Ladvien/cycloidal_drive/README.md

# cycloidal_drive
NEMA17 based cycloidal 3D printed drive
