Ladvien/cycloidal_drive/docs/design/img/exploded.png

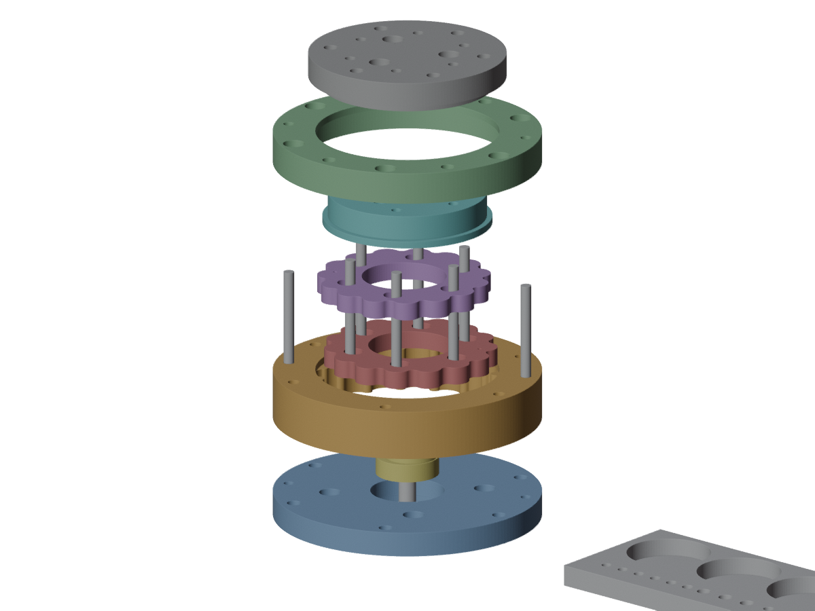
docs/design/img/exploded.png
