Ladvien/cycloidal_drive/docs/design/img/half_section.png

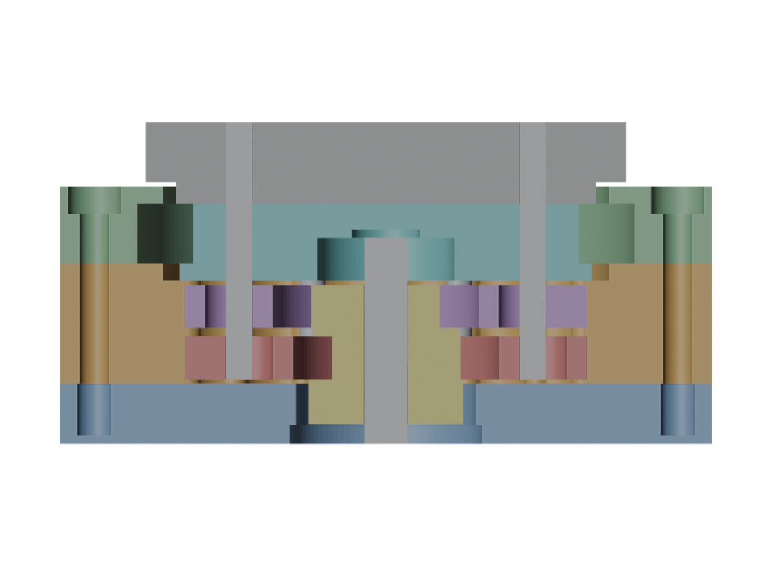
docs/design/img/half_section.png
