Ladvien/cycloidal_drive/docs/design/img/live/exploded.png

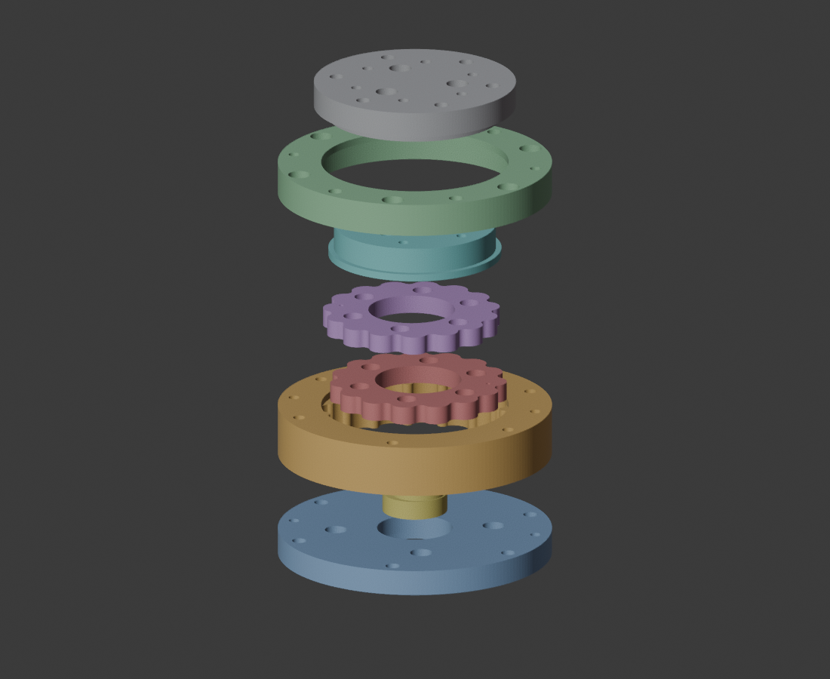
docs/design/img/live/exploded.png
