Ladvien/cycloidal_drive/docs/design/img/live/half_section.png

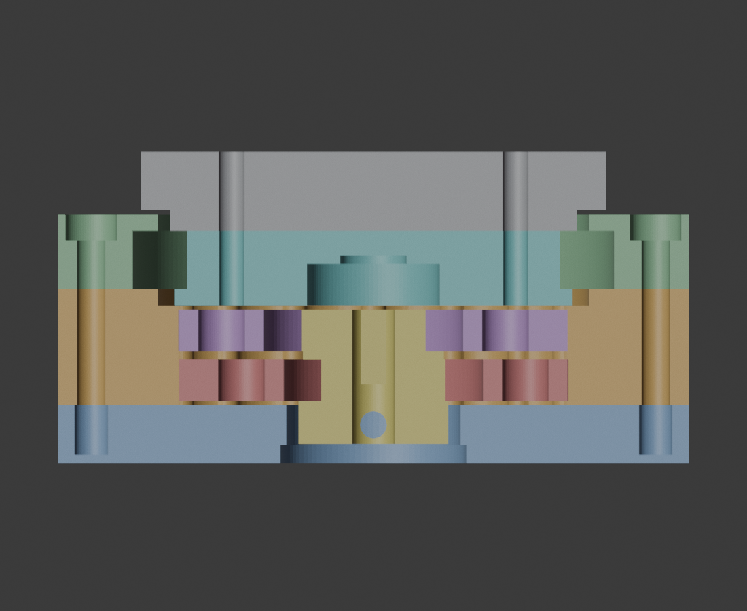
docs/design/img/live/half_section.png
