Ladvien/cycloidal_drive/docs/design/img/live/part_P0_coupon.png

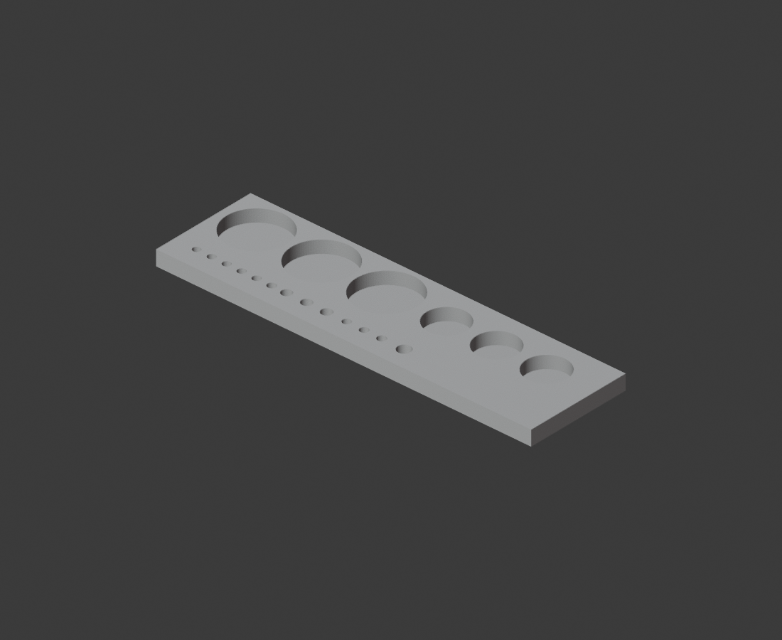
docs/design/img/live/part_P0_coupon.png
