Ladvien/cycloidal_drive/docs/design/img/live/part_P1_base.png

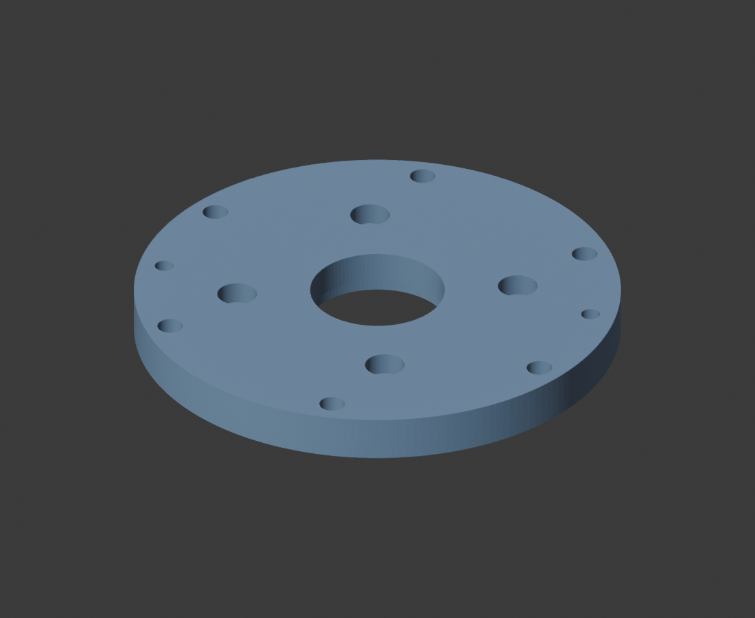
docs/design/img/live/part_P1_base.png
