Ladvien/cycloidal_drive/docs/design/img/live/part_P2_ring.png

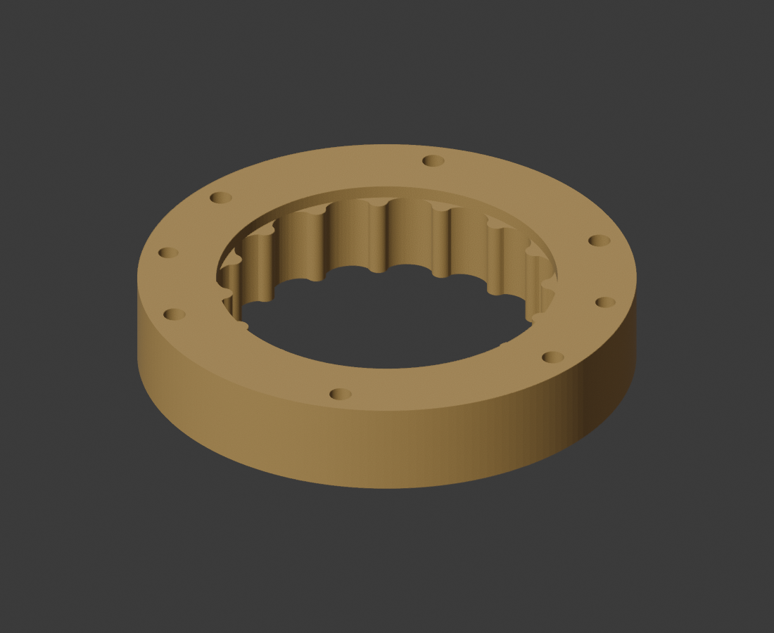
docs/design/img/live/part_P2_ring.png
