Ladvien/cycloidal_drive/docs/design/img/live/part_P3_cap.png

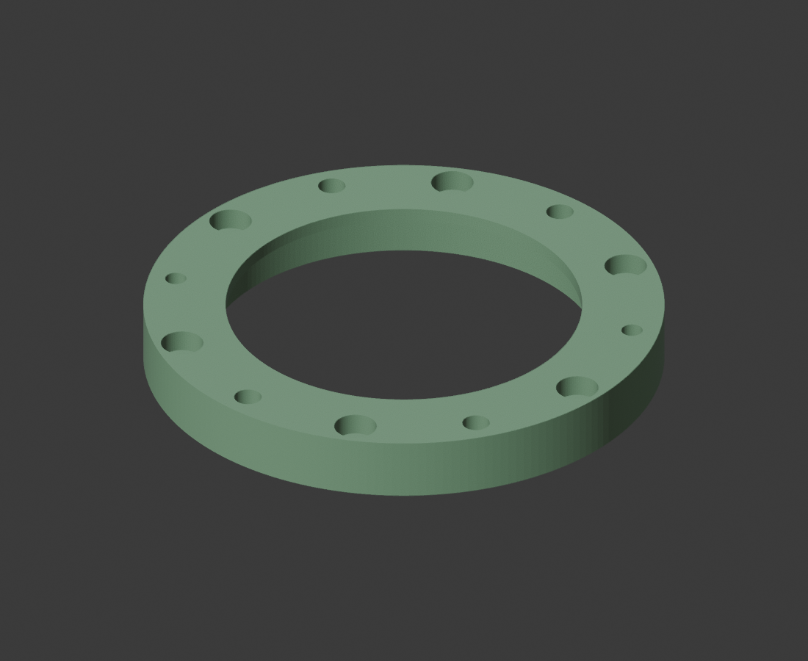
docs/design/img/live/part_P3_cap.png
