Ladvien/cycloidal_drive/docs/design/img/live/part_P5_cam.png

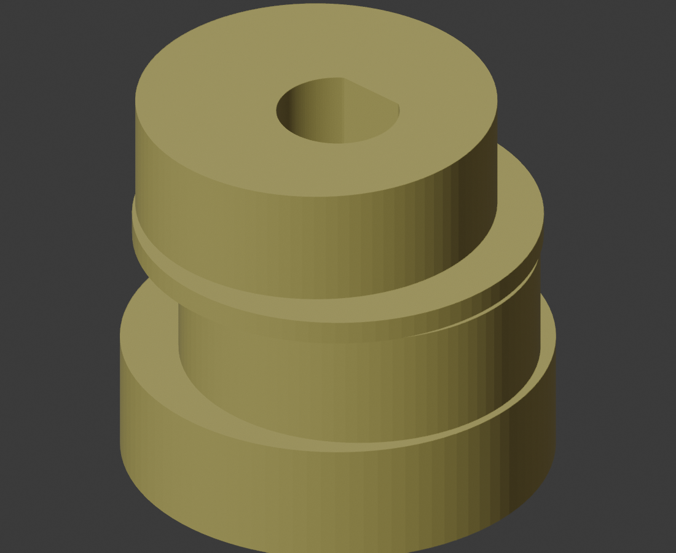
docs/design/img/live/part_P5_cam.png
