Ladvien/cycloidal_drive/docs/design/img/live/part_P6_carrier_lower.png

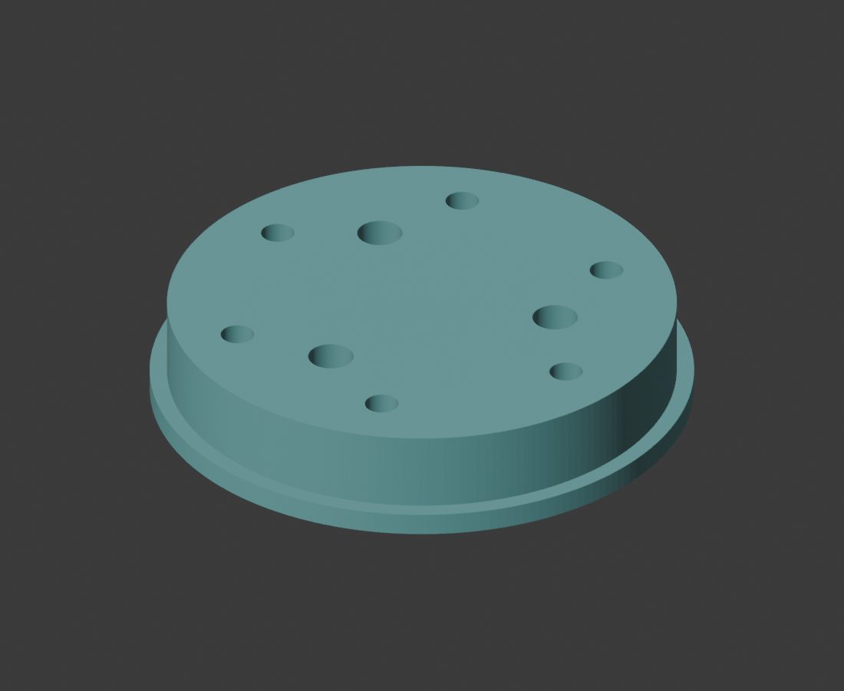
docs/design/img/live/part_P6_carrier_lower.png
