Ladvien/cycloidal_drive/docs/design/img/live/part_P7_carrier_upper.png

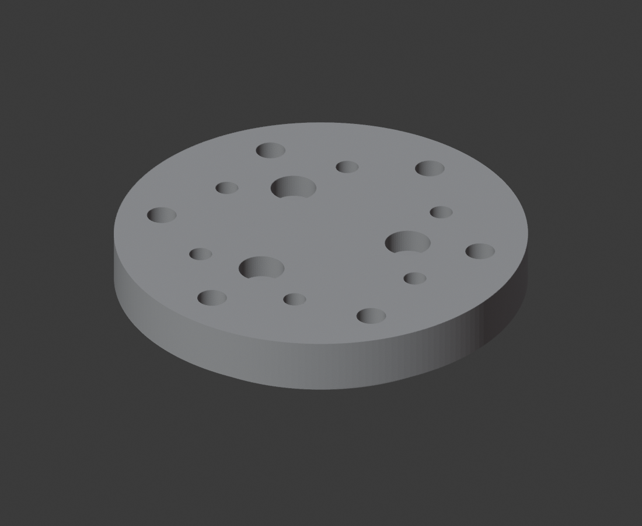
docs/design/img/live/part_P7_carrier_upper.png
