Ladvien/cycloidal_drive/docs/design/img/top_pinzone.png

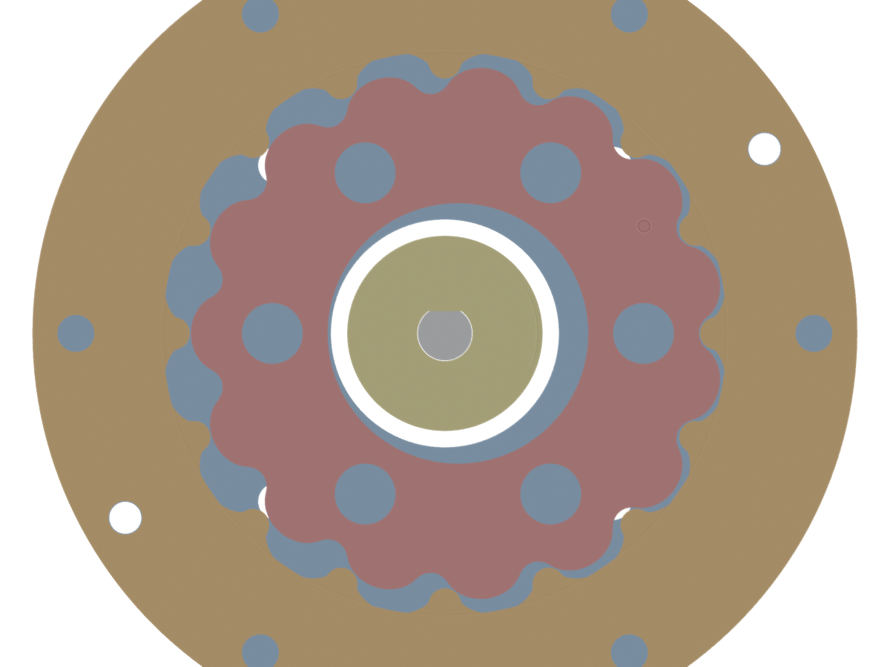
docs/design/img/top_pinzone.png
