Ladvien/cycloidal_drive/docs/design/img/live/parts_sheet.png

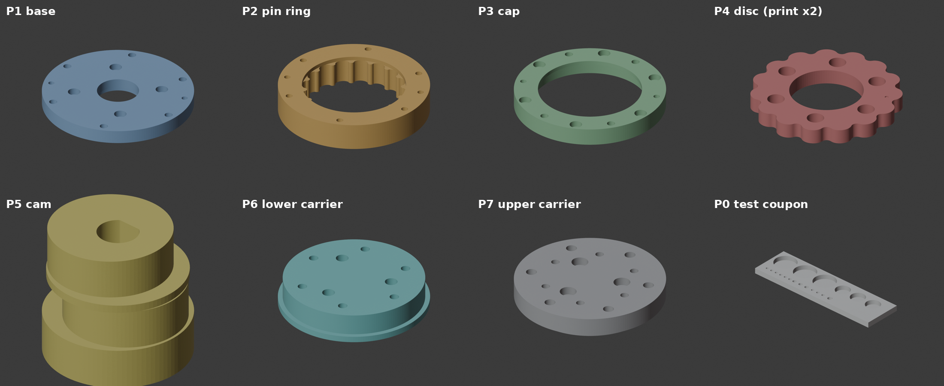
docs/design/img/live/parts_sheet.png
