Ladvien/cycloidal_drive/stl/_to_delete/04_P5_cam_ONE_PIECE_cannot_assemble.stl

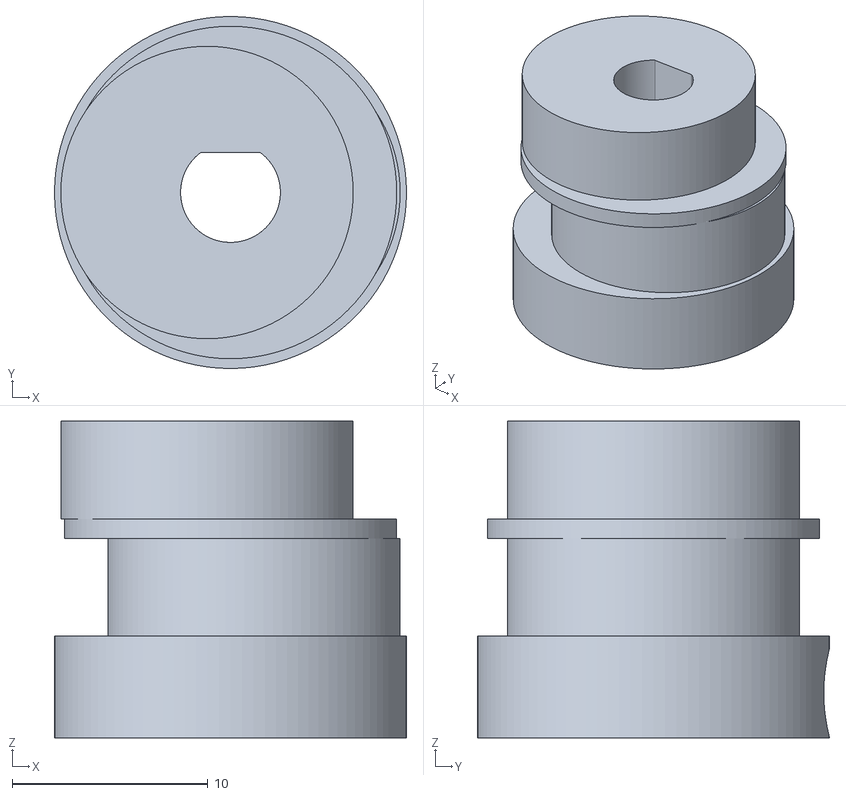
[picture p14: CAD file, 2026-09-28]
stl/_to_delete/04_P5_cam_ONE_PIECE_cannot_assemble.stl
18.0 x 18.0 x 16.2
