Ladvien/cycloidal_drive/stl/08_P7_carrier_upper.stl

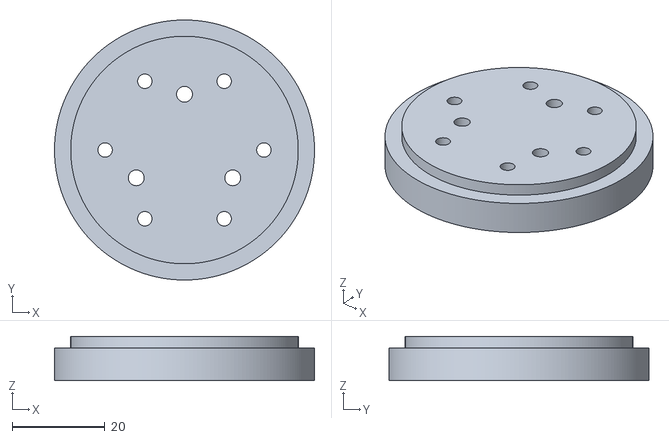
[picture p15: CAD file, 2026-09-28]
stl/08_P7_carrier_upper.stl
56.0 x 56.0 x 9.50
