Ladvien/cycloidal_drive/stl/_to_delete/P4_disc_x2.stl

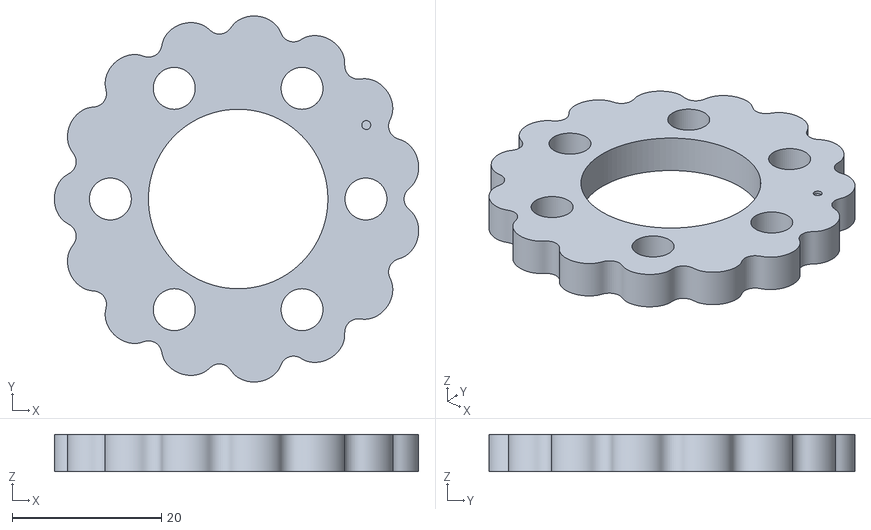
[picture p16: CAD file, 2026-09-28]
stl/_to_delete/P4_disc_x2.stl
48.8 x 49.0 x 5.00
