Ladvien/cycloidal_drive/stl/03_P6_carrier_lower.stl

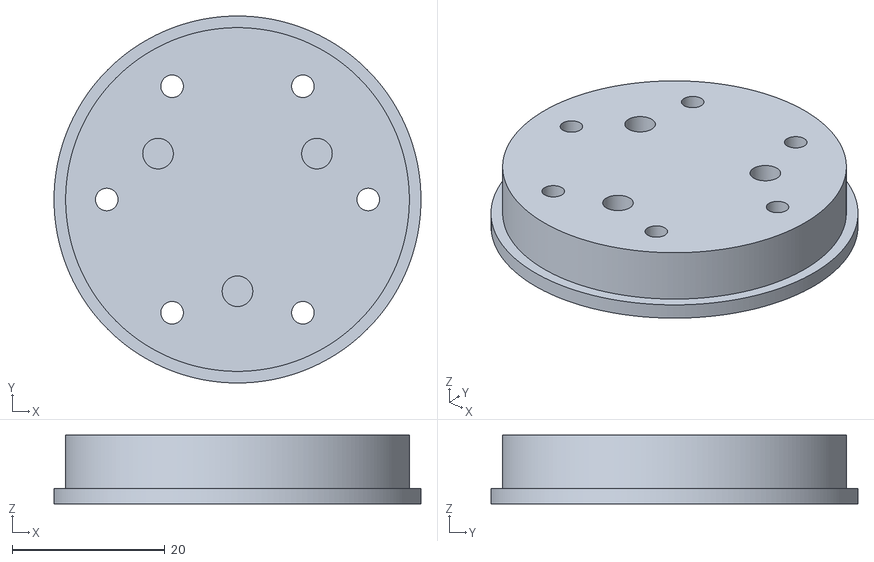
[picture p17: CAD file, 2026-09-28]
stl/03_P6_carrier_lower.stl
48.0 x 48.0 x 9.00
