Ladvien/cycloidal_drive/stl/04b_P5b_cam_upper.stl

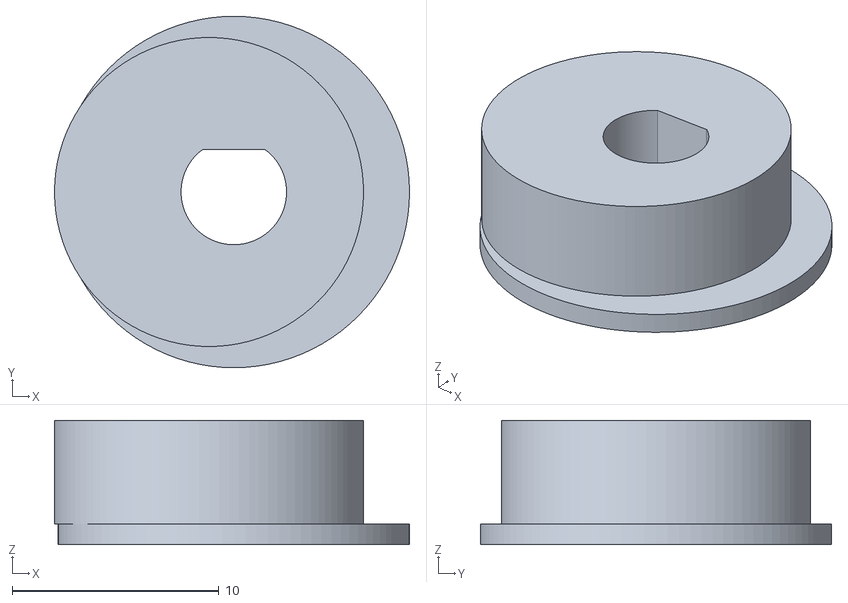
[picture p18: CAD file, 2026-09-28]
stl/04b_P5b_cam_upper.stl
17.2 x 17.0 x 6.00
