Ladvien/cycloidal_drive/stl/_to_delete/P2_ring.stl

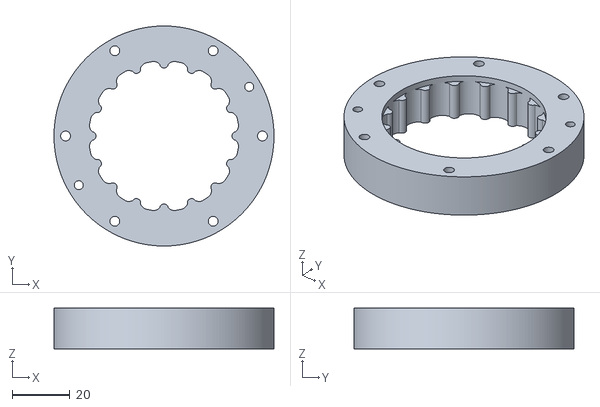
[picture p19: CAD file, 2026-09-28]
stl/_to_delete/P2_ring.stl
76.0 x 76.0 x 14.0
