Ladvien/cycloidal_drive/stl/01_P0_coupon.stl

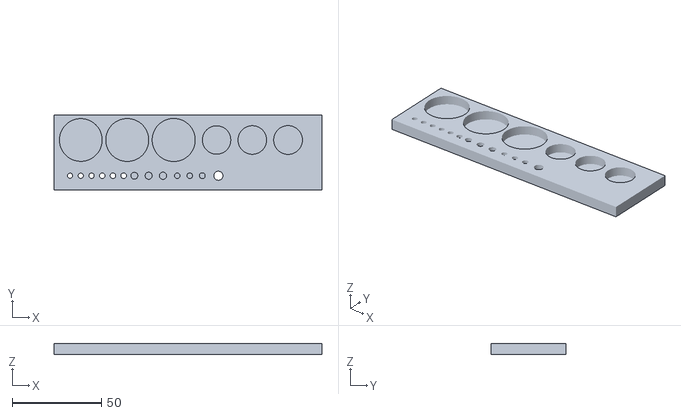
[picture p20: CAD file, 2026-09-28]
stl/01_P0_coupon.stl
150.0 x 42.0 x 6.00
