Ladvien/cycloidal_drive/stl/02_P3_cap.3mf

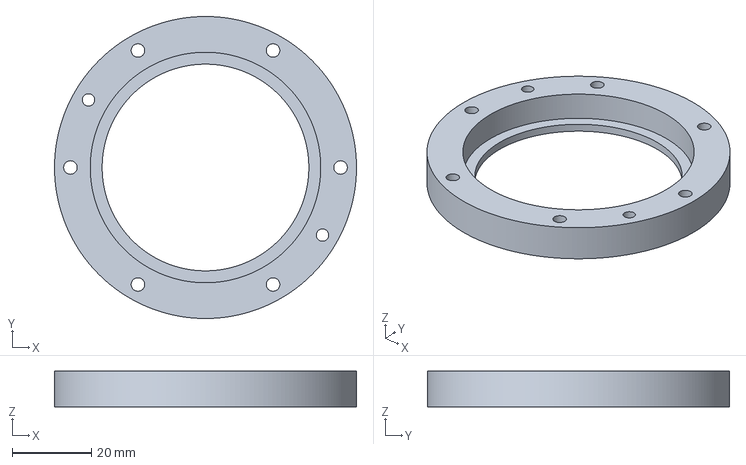
[picture p21: CAD file, 2026-09-28]
stl/02_P3_cap.3mf
76.0 x 76.0 x 9.00 mm
