Ladvien/cycloidal_drive/stl/04a_P5a_cam_lower.stl

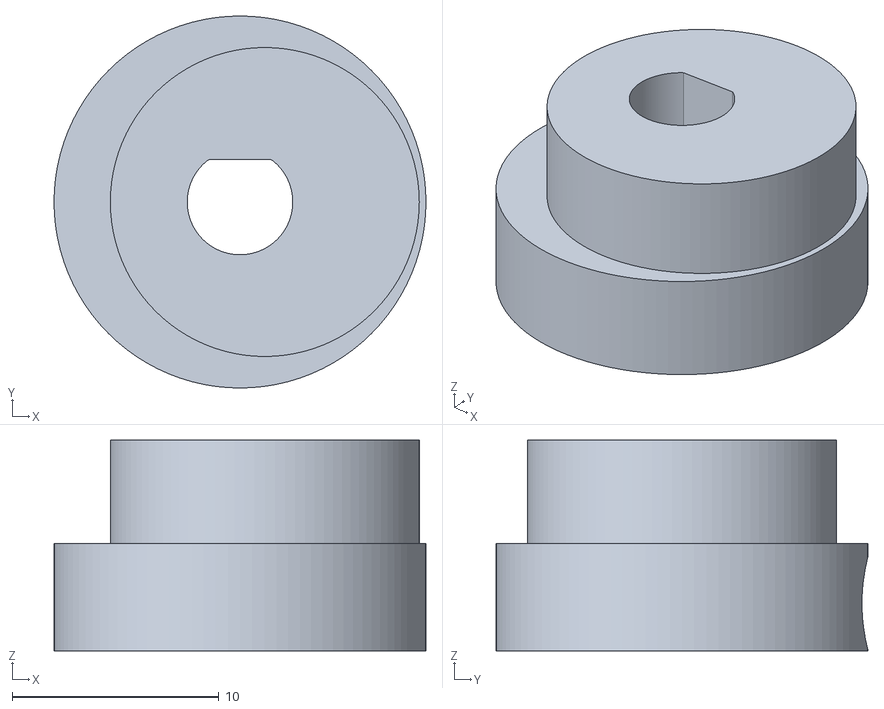
[picture p22: CAD file, 2026-09-28]
stl/04a_P5a_cam_lower.stl
18.0 x 18.0 x 10.2
