Ladvien/cycloidal_drive/stl/06_P1_base.stl

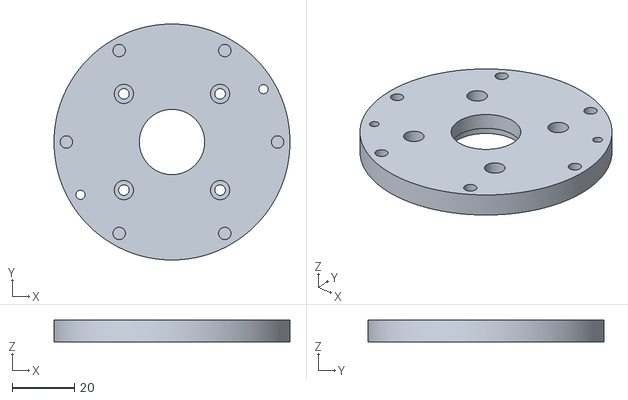
[picture p23: CAD file, 2026-09-28]
stl/06_P1_base.stl
76.0 x 76.0 x 7.00
