Ladvien/cycloidal_drive/(list of files, cad)

Other CAD files:
stl/_to_delete/P0_coupon.stl
stl/_to_delete/P3_cap.stl
stl/_to_delete/P1_base.stl
cycloidal_drive.blend
stl/02_P3_cap.stl
