Ladvien/cycloidal_drive/docs/design/img/assembly.png

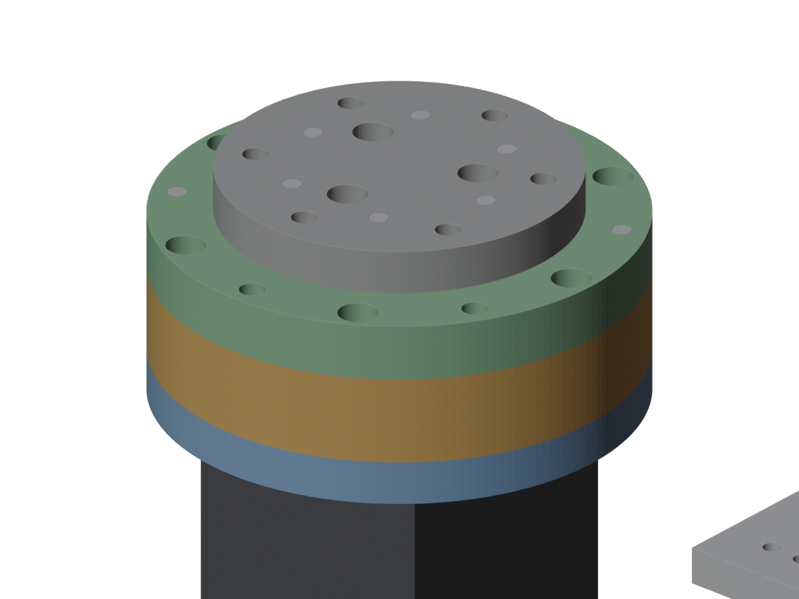
docs/design/img/assembly.png
