Ladvien/cycloidal_drive/docs/design/img/live/assembly.png

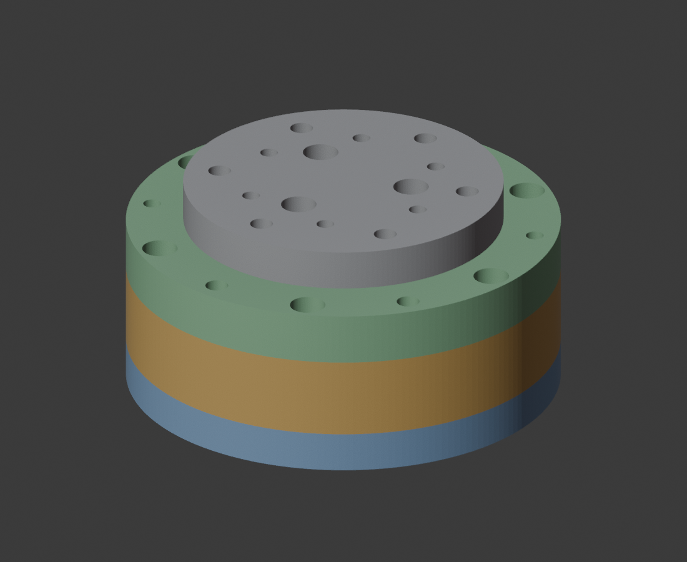
docs/design/img/live/assembly.png
